seidat1/Tiny/README.md

<h1>Tiny</h1>
<h2>COMP JU+TE R</h2>
<h3><a href="https://hc-ddr.hucki.net/wiki/lib/exe/fetch.php/tiny:jutecomp1.pdf">Zeitschrift Jugend und Technik 1988</a></h3>
<h3><a href="https://hc-ddr.hucki.net/wiki/lib/exe/fetch.php/tiny/buch.pdf">Buch Tiny</a></h3>
<a target=""

<p>
Schlagworte: Tiny, Comp JU+TE r, DDR, 1988, Jugend und Technik, Zeitschrift, Rechner, Computer, 4k
</p>

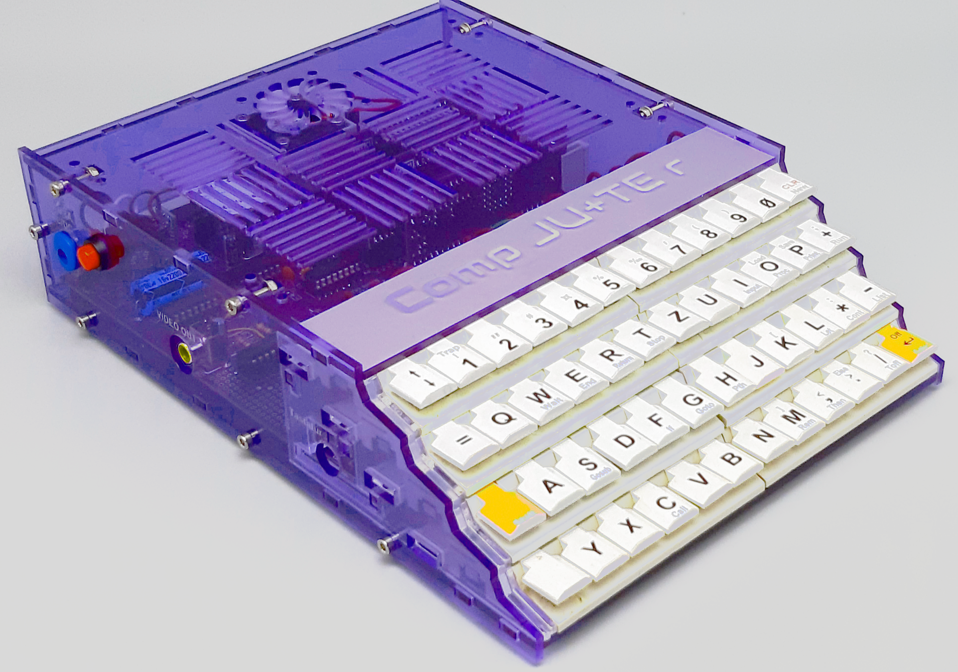
[picture p1: Bilder/vorne_links.png]
Comp Ju+TE r


<p>
Auch 35 Jahre nach Erscheinen der Artikel in des Zeitschrift Jugend und Technik werden noch "COMP JU+TE R" gebaut.
 Mir sind 2 Fälle bekannt. Beide Geräte sind lauffähig und beruhen auf der 4k-Version. Grundlage war die
 Anleitung im Buch "Tiny".
</p>

<p>
In meinem Gerät kamen Speichermodule vom Typ C zum Einsatz. Diese Steckkarte lässt sich mit 8k RAM und 8k
 EPROM bestücken. Zusätzlich wurde eine weitere Karte vom Typ C verbaut, die nur mit 8kByte RAM bestückt ist.
 Somit stehen 16k RAM zur Verfügung. Davon muss der Bildspeicher abgezogen werden.<br />
Im Gerät befindet sich eine 3. Steckkarte, auf der ein 512kByte ROM verbaut ist. Um den Adressbereich zu erweitern,
 wurde ein Zähler eingesetzt. Dieser ROM wird als ROM-Bank benutzt und beherbergt eine Datenbank mit Programmen
 für dieses Gerät.<br />
Verzichtet wurde bei meinem Gerät auf Erweiterungen, wie Tonbandanschluss und mehr.
</p>

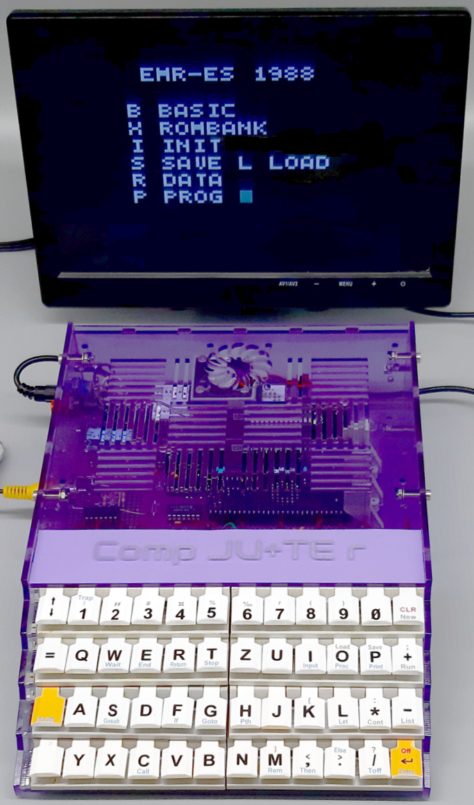
[picture p2: Bilder/Startbild.png]
Startbild


### Bilderverzeichnis:

<p>
  <table border="0">
<!-- ------------------------------ -->
    <tr>
      <td>
        <a href="./Bilder/vorne.png">Vorderansicht</a>
      </td>
      <td>
        <ul>
          <li>Vorderansicht</li>
        </ul>
      </td>
    </tr>
<!-- ------------------------------ -->
    <tr>
      <td>
        <a href="./Bilder/vorne_links.png">Ansicht vorne links</a>
      </td>
      <td>
        <ul>
          <li>Ansicht vorne links</li>
        </ul>
      </td>
    </tr>
<!-- ------------------------------ -->
    <tr>
      <td>
        <a href="./Bilder/vorne_oben.png">Ansicht vorne oben</a>
      </td>
      <td>
        <ul>
          <li>Ansicht vorne oben</li>
        </ul>
      </td>
    </tr>
<!-- ------------------------------ -->
    <tr>
      <td>
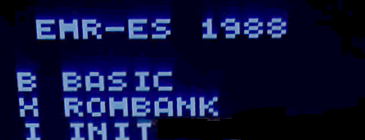
[picture p3: Bilder/verkleinert/Startbild_150px.png]
Startbild
        
      </td>
      <td>
        <ul>
          <li>Startbild</li>
        </ul>
      </td>
    </tr>
<!-- ------------------------------ -->
    <tr>
      <td>
        <a href="./Bilder/Turm_von_Hanoi.png">Turm von Hanoi</a>
      </td>
      <td>
        <ul>
          <li>Turm von Hanoi</li>
        </ul>
      </td>
    </tr>
<!-- ------------------------------ -->
    <tr>
      <td>
        <a href="./Bilder/links.png">linke Seite</a>
      </td>
      <td>
        <ul>
          <li>Netzanschluss Hohlbuchse 2,1/5,5</li>
          <li>Resettaster</li>
          <li>Compositanschluss</li>
        </ul>
      </td>
    </tr>
<!-- ------------------------------ -->
    <tr>
      <td>
        <a href="./Bilder/innen_hinten.png">innen hinten</a>
      </td>
      <td>
        <ul>
          <li>Innenansicht von hinten</li>
        </ul>
      </td>
    </tr>
<!-- ------------------------------ -->
    <tr>
      <td>
        <a href="./Bilder/innen_vorn_oben.png">innen_vorn_oben</a>
      </td>
      <td>
        <ul>
          <li>Innenansicht von vorn oben</li>
        </ul>
      </td>
    </tr>
<!-- ------------------------------ -->
    <tr>
      <td>
        <a href="./Bilder/Speicherkarten.png">Speicherkarten</a>
      </td>
      <td>
        <ul>
          <li>Speicherkarten</li>
        </ul>
      </td>
    </tr>
<!-- ------------------------------ -->
    <tr>
      <td>
        <a href="./Bilder/Platinenhalter.png">Platinenhalter</a>
      </td>
      <td>
        <ul>
          <li>Platinenhalter</li>
        </ul>
      </td>
    </tr>
<!-- ------------------------------ -->
    <tr>
      <td>
        <a href="./Bilder/Prozessor_Luefter.png">Prozessor Lüfter</a>
      </td>
      <td>
        <ul>
          <li>Prozessor L&uuml;fter</li>
        </ul>
      </td>
    </tr>
<!-- ------------------------------ -->
    <tr>
      <td>
        <a href="./Bilder/Leiterplatte_Hauptplatine_oben.png">Hauptplatine</a>
      </td>
      <td>
        <ul>
          <li>Hauptleiterplatte</li>
        </ul>
      </td>
    </tr>
<!-- ------------------------------ -->
    <tr>
      <td>
        <a href="./Bilder/Leiterplatte_Tastatur.png">Leiterplatte Tastatur</a>
      </td>
      <td>
        <ul>
          <li>Leiterplatte Tastatur</li>
        </ul>
      </td>
    </tr>
<!-- ------------------------------ -->
    <tr>
      <td>
        <a href="./Bilder/Leiterplatte_ROM_RAM.png">ROM RAM (Typ C)</a>
      </td>
      <td>
        <ul>
          <li>Leiterplatte ROM RAM</li>
        </ul>
      </td>
    </tr>
<!-- ------------------------------ -->
    <tr>
      <td>
        <a href="./Bilder/Leiterplatte_ROM_BANK.png">ROM_BANK</a>
      </td>
      <td>
        <ul>
          <li>Leiterplatte ROM BANK</li>
        </ul>
      </td>
    </tr>
<!-- ------------------------------ -->
    <tr>
      <td>
        <a href="./Bilder/UB8821_oben.png">UB8821 Bestückungsseite</a>
      </td>
      <td>
        <ul>
          <li>UB8821 Best&uuml;ckungsseite</li>
        </ul>
      </td>
    </tr>
<!-- ------------------------------ -->
    <tr>
      <td>
        <a href="./Bilder/UB8821_unten.png">UB8821 Leiterseite</a>
      </td>
      <td>
        <ul>
          <li>UB8821 Leiterseite</li>
        </ul>
      </td>
    </tr>
<!-- ------------------------------ -->
  </table>
</p>
