seidat1/Tiny/Bilder/innen_hinten.png

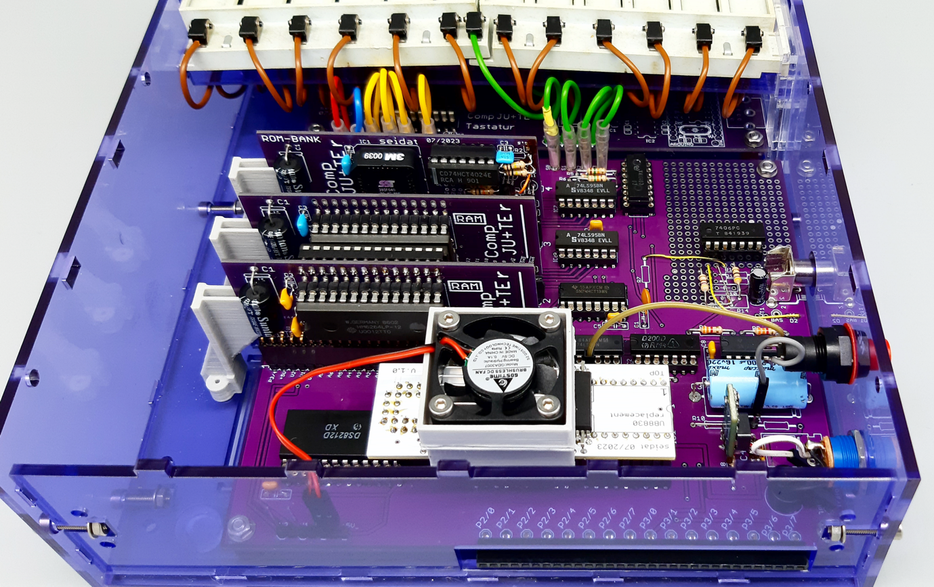
Bilder/innen_hinten.png
