seidat1/Tiny/Bilder/innen_vorn_oben.png

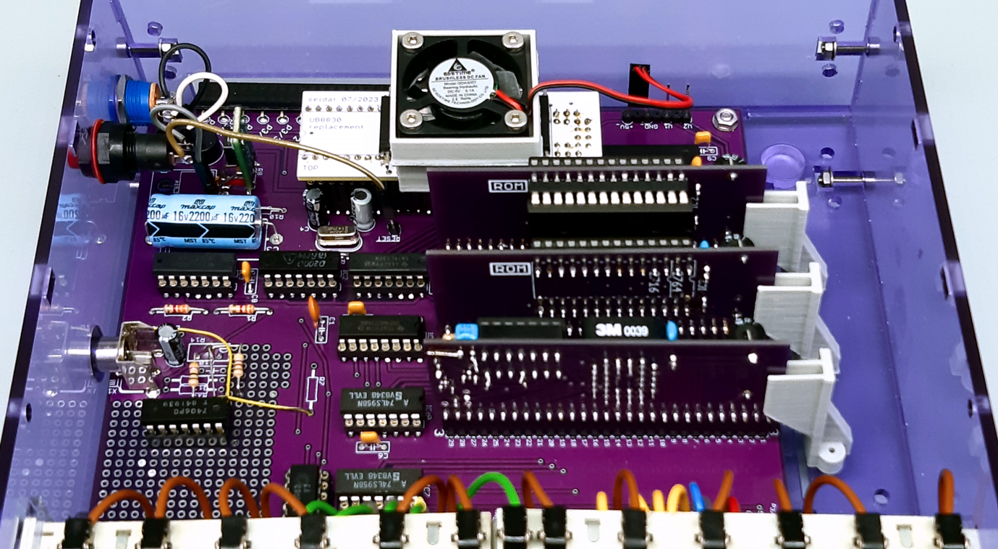
Bilder/innen_vorn_oben.png
