seidat1/Tiny/Bilder/Leiterplatte_Hauptplatine_oben.png

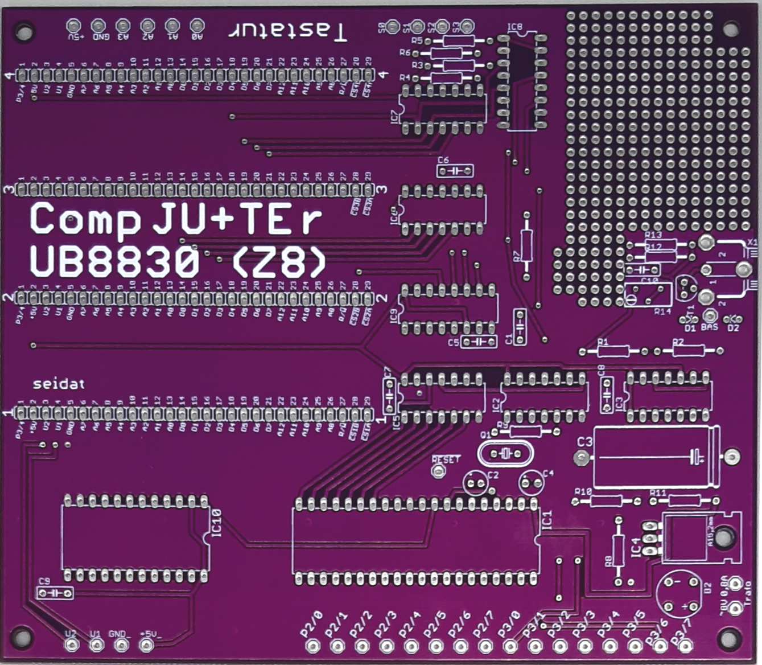
Bilder/Leiterplatte_Hauptplatine_oben.png
