seidat1/Tiny/Bilder/Leiterplatte_ROM_RAM.png

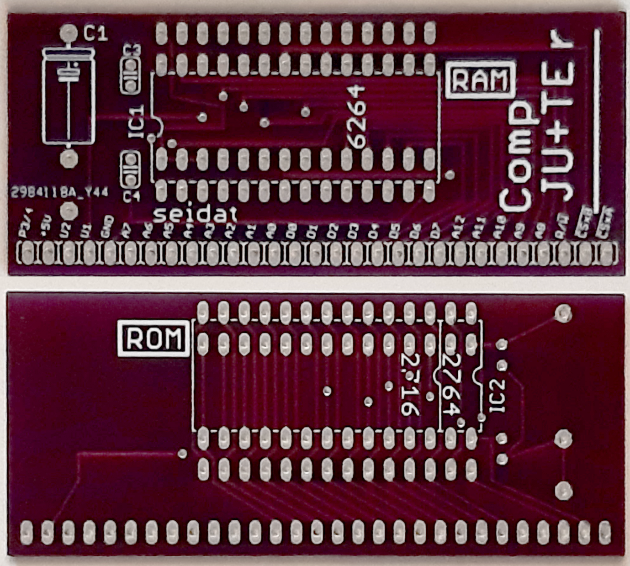
Bilder/Leiterplatte_ROM_RAM.png
