seidat1/Tiny/Bilder/Speicherkarten.png

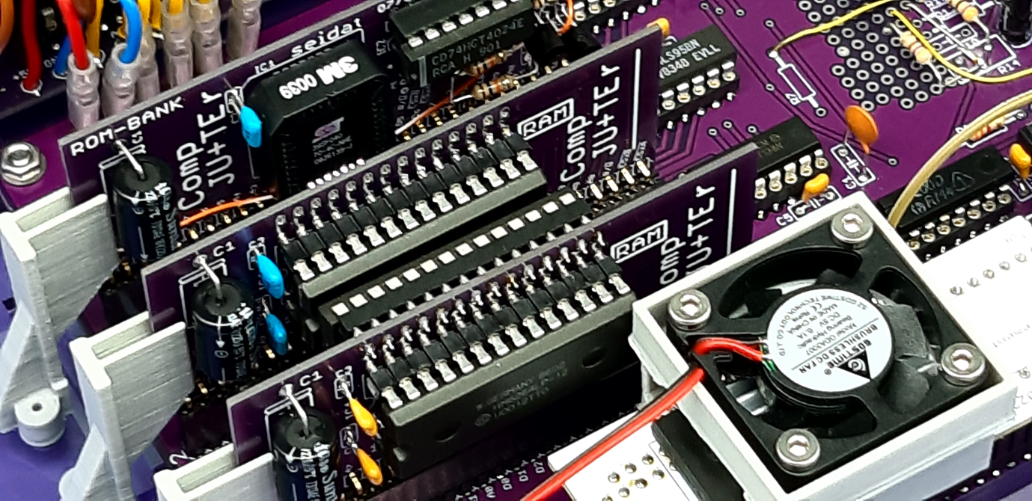
Bilder/Speicherkarten.png
