seidat1/Tiny/Bilder/Turm_von_Hanoi.png

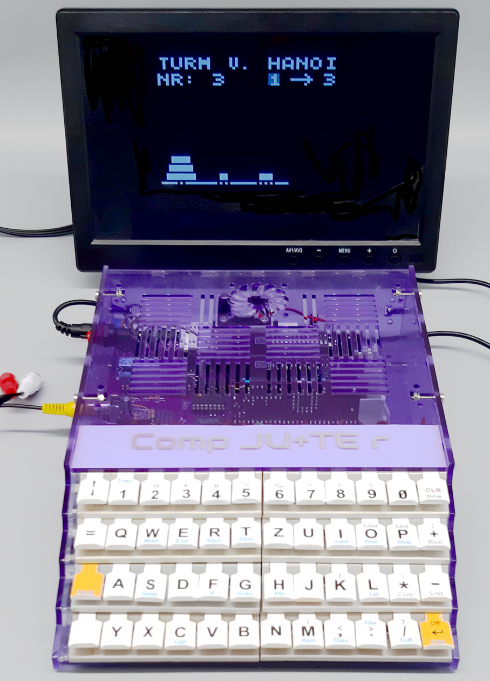
Bilder/Turm_von_Hanoi.png
