seidat1/Tiny/Bilder/UB8821_unten.png

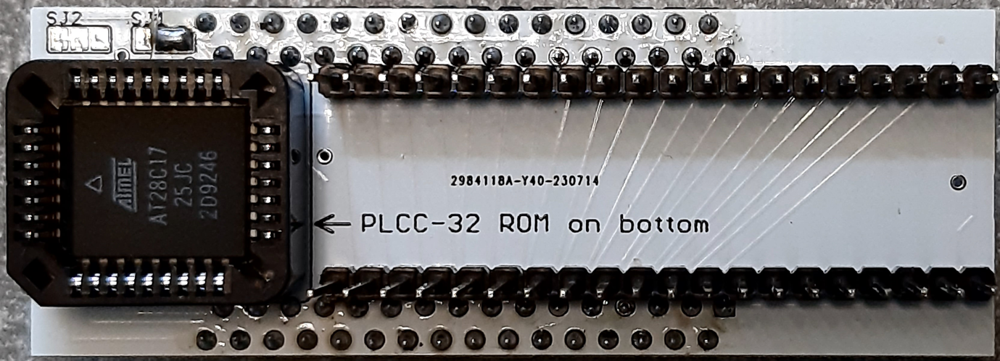
Bilder/UB8821_unten.png
