seidat1/Tiny/Bilder/vorne.png

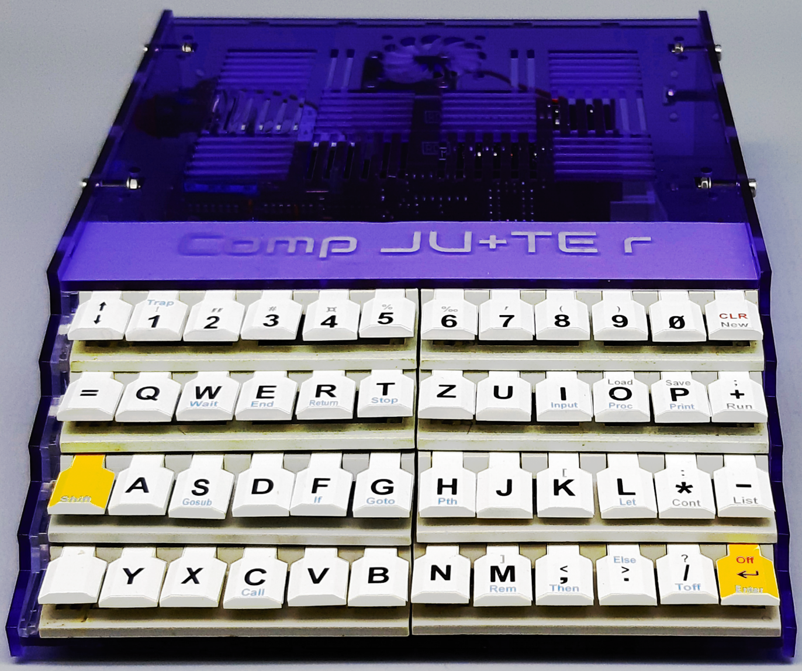
Bilder/vorne.png
