seidat1/Tiny/Bilder/vorne_oben.png

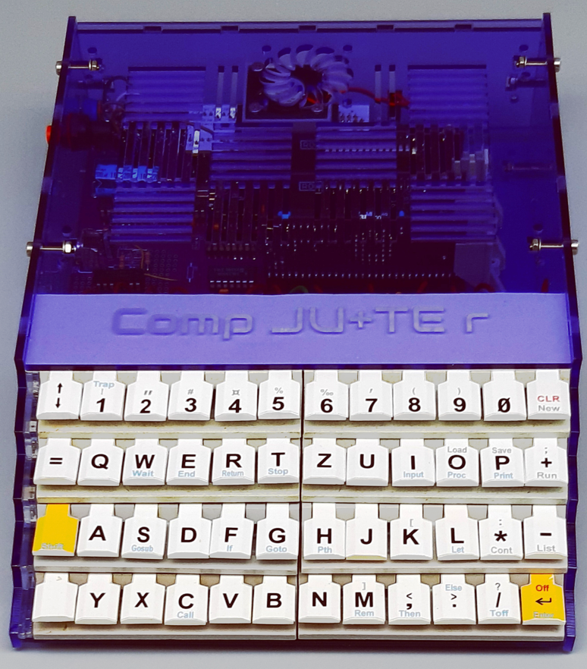
Bilder/vorne_oben.png
