seidat1/Tiny/Konstruktionsdateien/ROM BANK/Bestueckungsseite lila.png

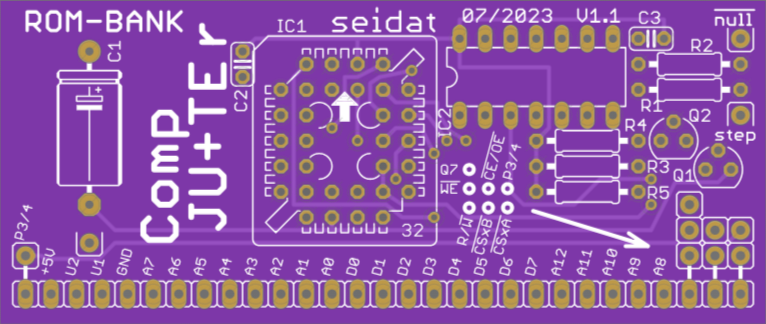
Konstruktionsdateien/ROM BANK/Bestueckungsseite lila.png
