seidat1/Tiny/Konstruktionsdateien/ROM BANK/Leiterseite lila.png

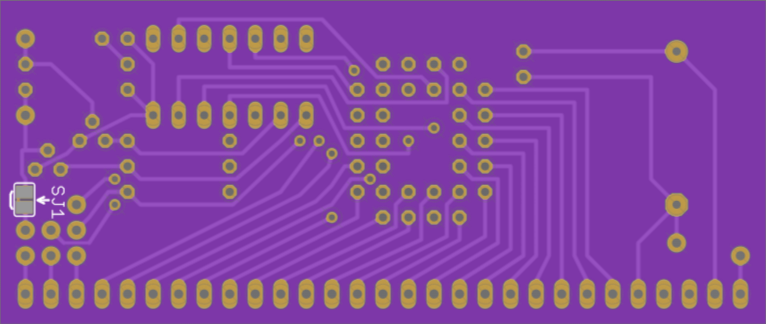
Konstruktionsdateien/ROM BANK/Leiterseite lila.png
