seidat1/Tiny/Konstruktionsdateien/ROM BANK/Leiterseite.png

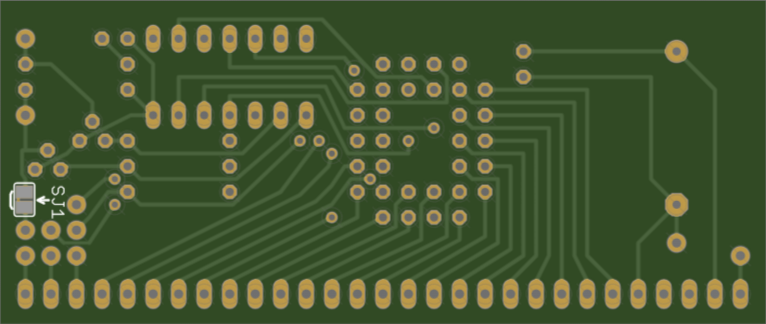
Konstruktionsdateien/ROM BANK/Leiterseite.png
