seidat1/Tiny/Konstruktionsdateien/Speicherkarte Typ C/Bestueckungsseite lila.png

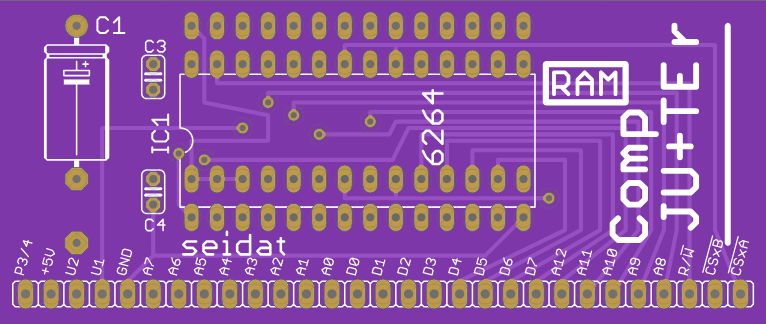
Konstruktionsdateien/Speicherkarte Typ C/Bestueckungsseite lila.png
