seidat1/Tiny/Konstruktionsdateien/Speicherkarte Typ C/Leiterseite lila.png

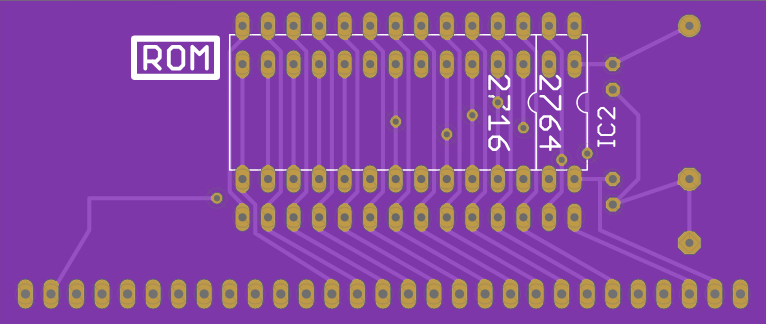
Konstruktionsdateien/Speicherkarte Typ C/Leiterseite lila.png
