seidat1/Tiny/Konstruktionsdateien/Tastatur/Bestueckungsseite lila.png

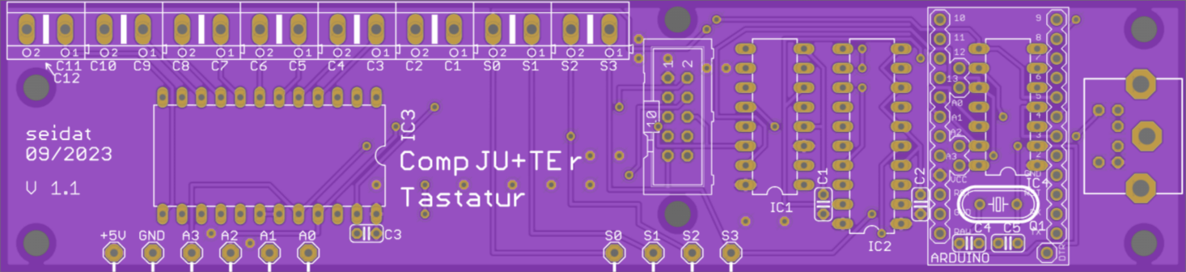
Konstruktionsdateien/Tastatur/Bestueckungsseite lila.png
