seidat1/Tiny/Konstruktionsdateien/Tastatur/Bestueckungsseite.png

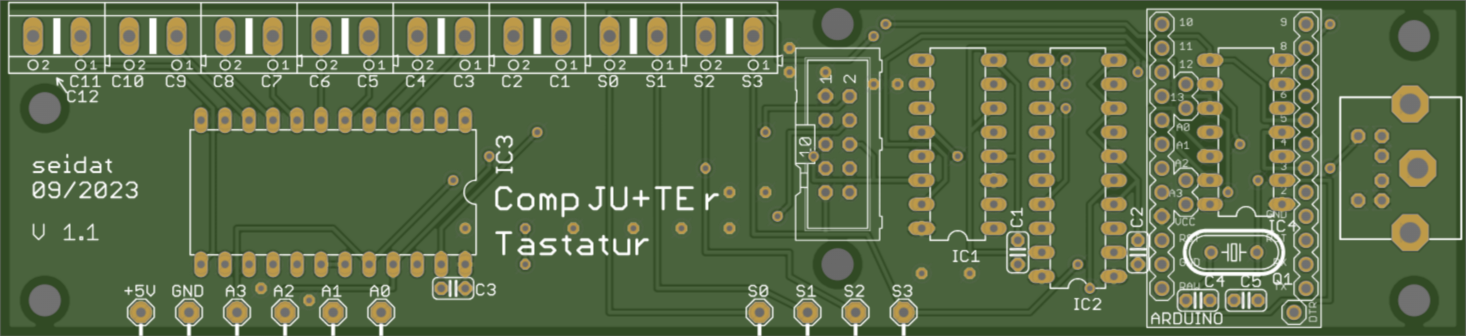
Konstruktionsdateien/Tastatur/Bestueckungsseite.png
