seidat1/Tiny/Konstruktionsdateien/Tastatur/Leiterseite lila.png

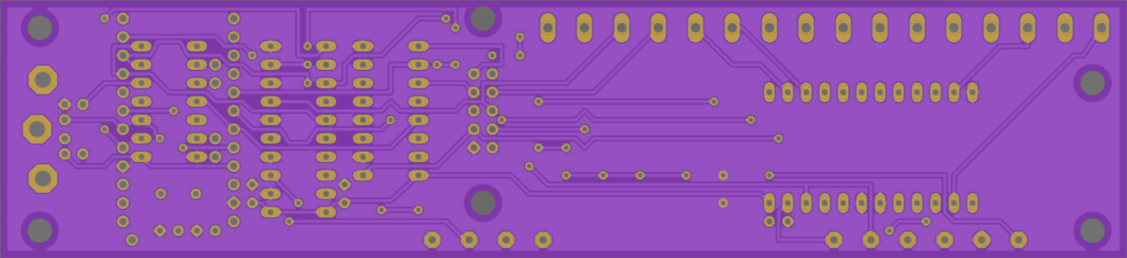
Konstruktionsdateien/Tastatur/Leiterseite lila.png
