seidat1/Tiny/Konstruktionsdateien/Tastatur/Leiterseite.png

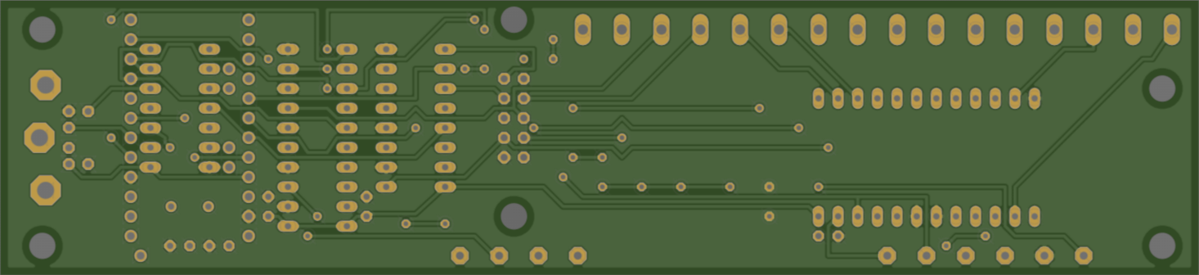
Konstruktionsdateien/Tastatur/Leiterseite.png
