seidat1/Tiny/Konstruktionsdateien/UB8830 Ersatz/Bestueckungsseite lila.png

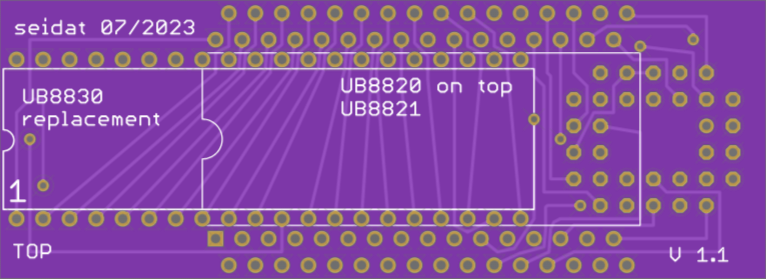
Konstruktionsdateien/UB8830 Ersatz/Bestueckungsseite lila.png
