seidat1/Tiny/Konstruktionsdateien/UB8830 Ersatz/Bestueckungsseite.png

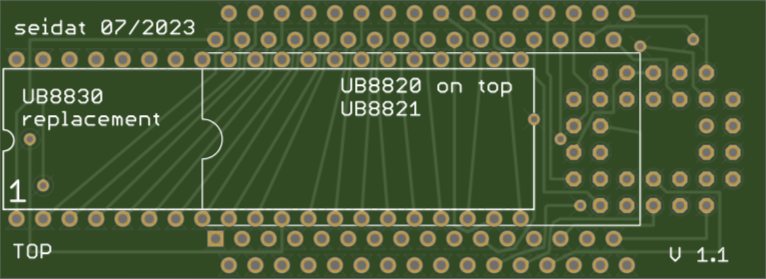
Konstruktionsdateien/UB8830 Ersatz/Bestueckungsseite.png
