seidat1/Tiny/Konstruktionsdateien/UB8830 Ersatz/Leiterseite lila.png

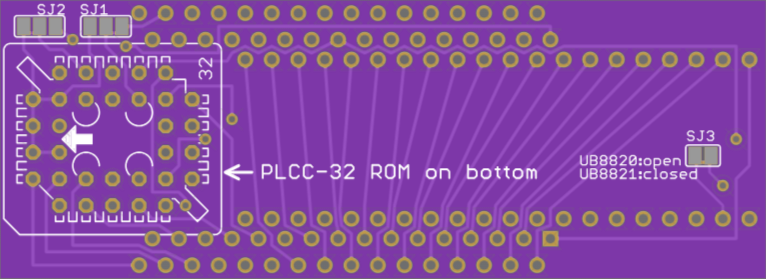
Konstruktionsdateien/UB8830 Ersatz/Leiterseite lila.png
