seidat1/Tiny/Konstruktionsdateien/UB8830 Ersatz/Leiterseite.png

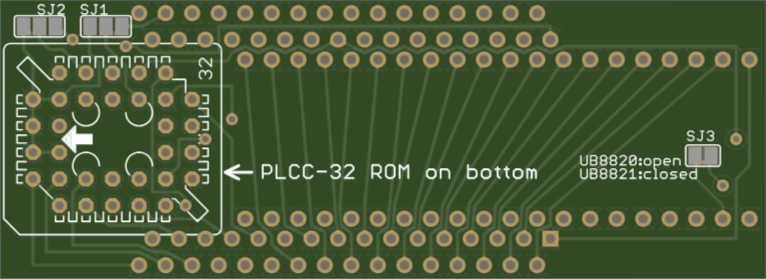
Konstruktionsdateien/UB8830 Ersatz/Leiterseite.png
