seidat1/Tiny/Konstruktionsdateien/Tastatur/Tastatur Abziehbilder.pdf

W

S

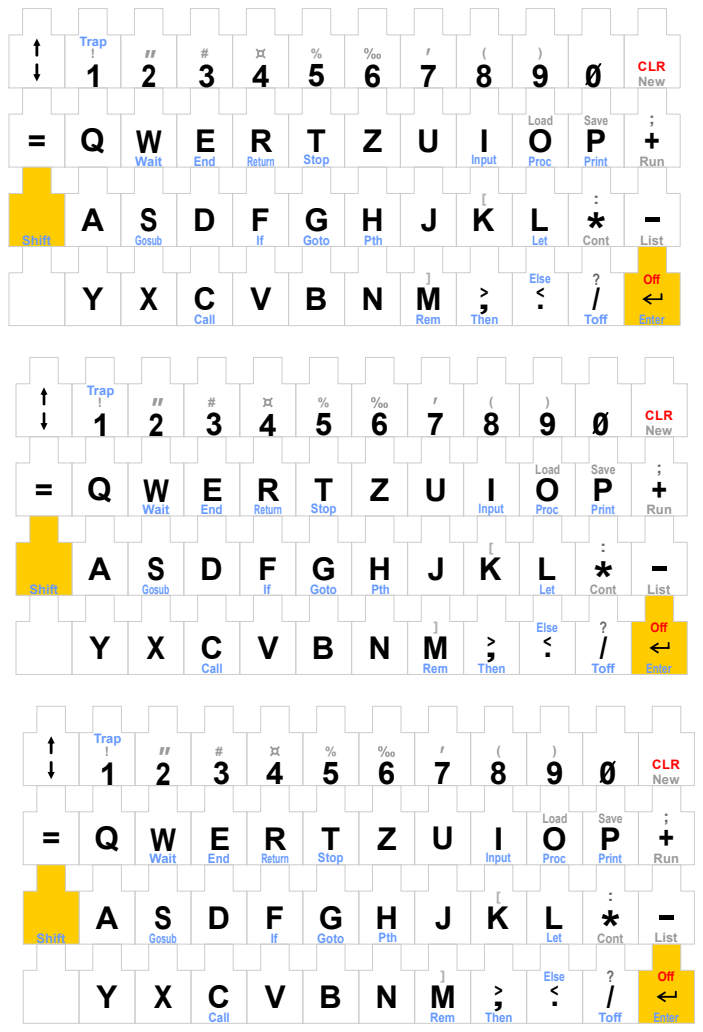
[picture p26: page 1]
Save; Load; Else; Off; Toff; Enter; List; Cont; Run; New; CLR; Input; Proc; Let; Print; Stop; End; Call; Wait; Gosub; Shift; Trap; Goto; Pth; Rem; Then; Return
