seidat1/Tiny/Konstruktionsdateien/Tastatur/Schaltplan.pdf

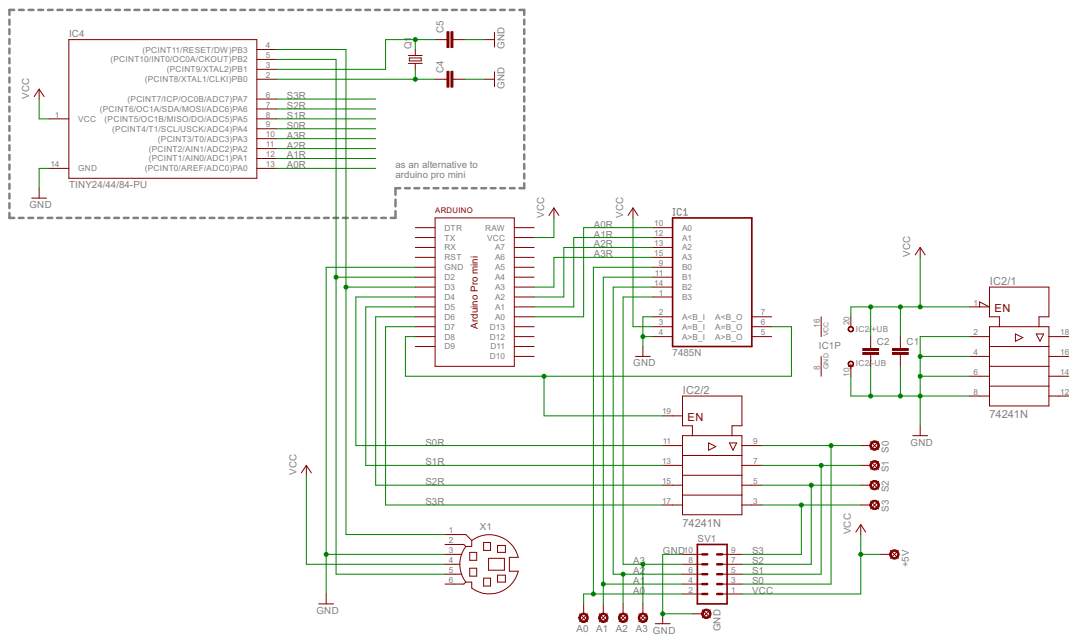
[picture p27: page 1]

6 S3R
7 S2R
8 S1R

GND 14 | 9 S0R

as an alternative to
arduino pro mini

A1R | | A1 12
A2R | | A2 13
A3R | | A3 15

B1 11
B2 14

S1R | 13
S2R | 15
S3R | 17

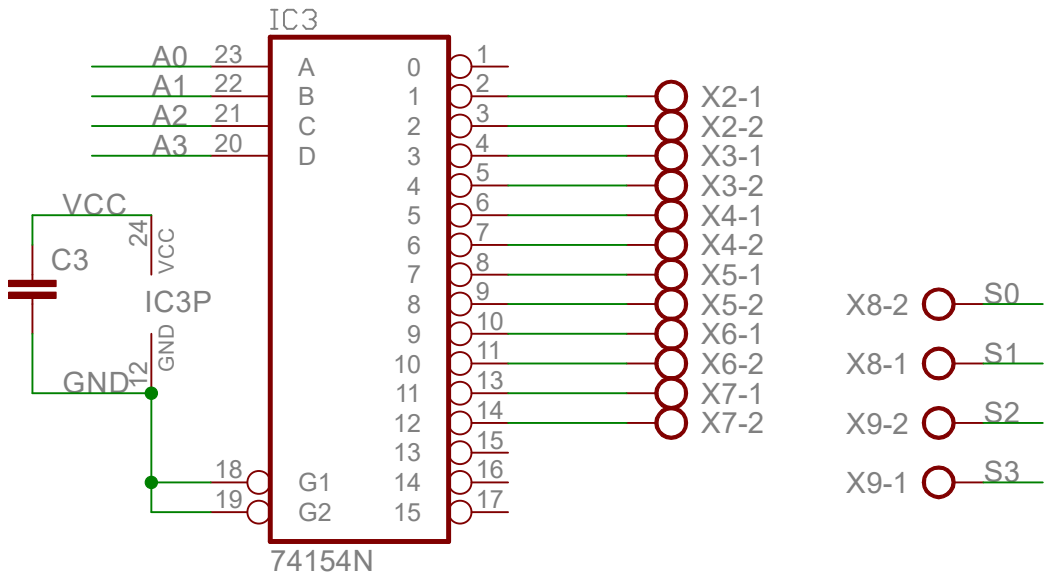
[picture p28: page 2]
IC3PGND VCC; GND; VCC
