seidat1/Tiny/Konstruktionsdateien/ROM BANK/Schaltplan.pdf

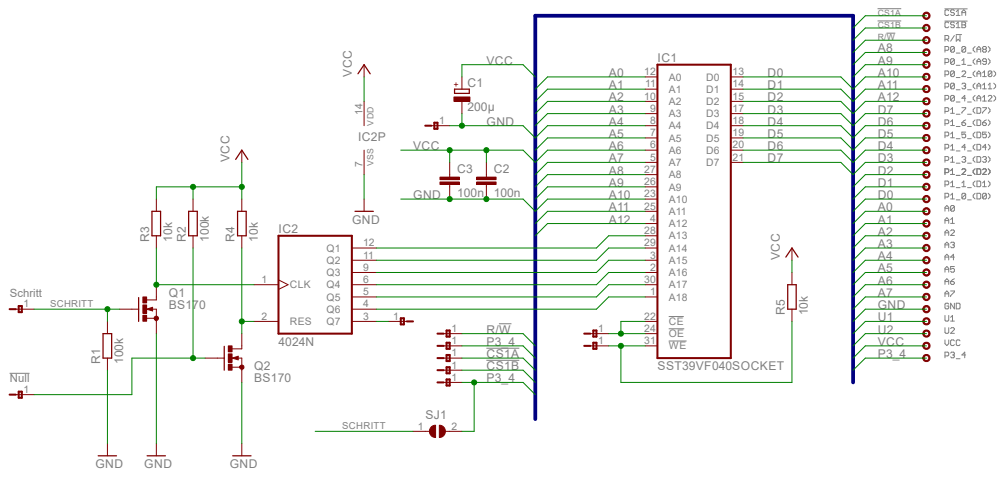
[picture p29: page 1]
