seidat1/Tiny/Konstruktionsdateien/Speicherkarte Typ C/Schaltplan.pdf

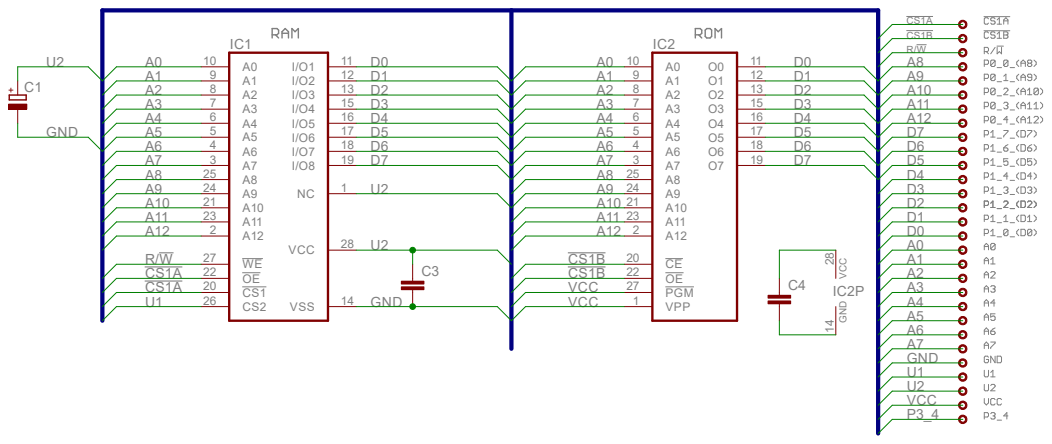
[picture p30: page 1]
