seidat1/Tiny/Konstruktionsdateien/Tastatur/Tastatur_102 EAGLE 630.brd

## EAGLE design Konstruktionsdateien/Tastatur/Tastatur_102 EAGLE 630.brd (2023-10-23)

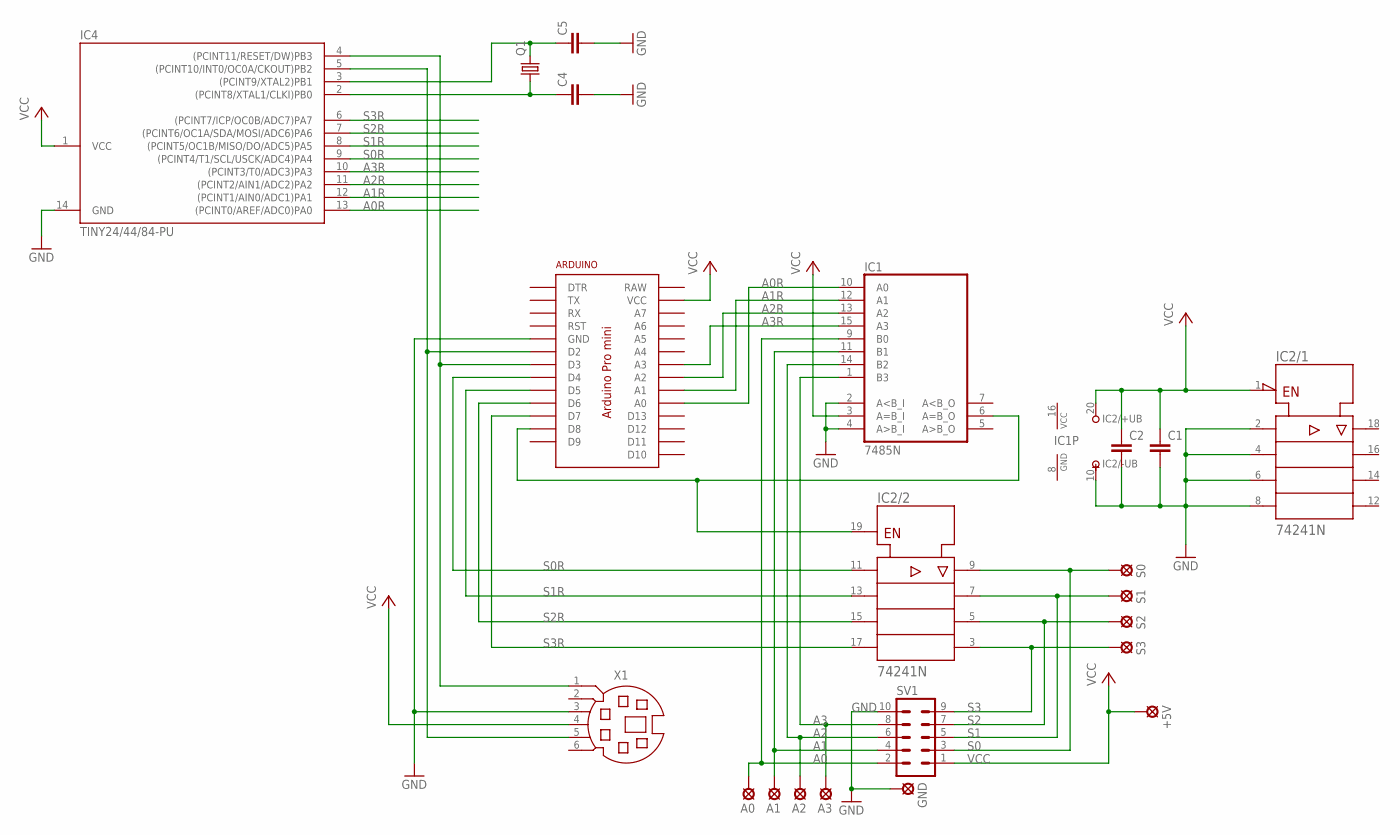
[picture p31: schematic Tastatur_102 EAGLE 630.sch, sheet 1]

Parts:
+5V: MCS10B
A0, A1, A2, A3: MCS10B
ARDUINO: ARDUINO_PRO_MINIARDUINO_PRO_MINI_8; ARDUINO_PRO_MINI_8
C1, C2, C4, C5: C-EU025-024X044; C025-024X044
GND: MCS10B
IC1: 7485N; DIL16
IC2: 74241N; DIL20
IC4: TINY24/44/84-PU; DIL14
Q1: CRYSTALHC49U-V; HC49U-V
S0, S1, S2, S3: MCS10B
SV1: ML10
X1: MD06SSMDIN06L; MDIN06SSL

Connections:
A0: A0.MP, IC1.9 (B0), SV1.2; also elsewhere on the board
A0R: ARDUINO.A0, IC1.10 (A0), IC4.13 ((PCINT0/AREF/ADC0)PA0)
A1: A1.MP, IC1.11 (B1), SV1.4; also elsewhere on the board
A1R: ARDUINO.A1, IC1.12 (A1), IC4.12 ((PCINT1/AIN0/ADC1)PA1)
A2: A2.MP, IC1.14 (B2), SV1.6; also elsewhere on the board
A2R: ARDUINO.A2, IC1.13 (A2), IC4.11 ((PCINT2/AIN1/ADC2)PA2)
A3: A3.MP, IC1.1 (B3), SV1.8; also elsewhere on the board
A3R: ARDUINO.A3, IC1.15 (A3), IC4.10 ((PCINT3/T0/ADC3)PA3)
GND: ARDUINO.GND, ARDUINO.GND@1 (GND), C1.2, C2.2, C4.2, C5.2, GND.MP, IC1.2 (A<B_I), IC1.4 (A>B_I), IC1.8 (GND), IC2.2 (A1), IC2.4 (A2), IC2.6 (A3), IC2.8 (A4), IC2.10 (-UB), IC4.14 (GND), SV1.10, X1.3; also elsewhere on the board
unnamed: ARDUINO.D2, IC4.5 ((PCINT10/INT0/OC0A/CKOUT)PB2), X1.5
unnamed: ARDUINO.D3, IC4.4 ((PCINT11/RESET/DW)PB3), X1.1
unnamed: C4.1, IC4.2 ((PCINT8/XTAL1/CLKI)PB0), Q1.1
unnamed: C5.1, IC4.3 ((PCINT9/XTAL2)PB1), Q1.2
unnamed: ARDUINO.D8, IC1.6 (A=B_O), IC2.19 (G)
S0: IC2.9 (Y1), S0.MP, SV1.3; also elsewhere on the board
S0R: ARDUINO.D4, IC2.11 (A1), IC4.9 ((PCINT4/T1/SCL/USCK/ADC4)PA4)
S1: IC2.7 (Y2), S1.MP, SV1.5; also elsewhere on the board
S1R: ARDUINO.D5, IC2.13 (A2), IC4.8 ((PCINT5/OC1B/MISO/DO/ADC5)PA5)
S2: IC2.5 (Y3), S2.MP, SV1.7; also elsewhere on the board
S2R: ARDUINO.D6, IC2.15 (A3), IC4.7 ((PCINT6/OC1A/SDA/MOSI/ADC6)PA6)
S3: IC2.3 (Y4), S3.MP, SV1.9; also elsewhere on the board
S3R: ARDUINO.D7, IC2.17 (A4), IC4.6 ((PCINT7/ICP/OC0B/ADC7)PA7)
VCC: +5V.MP, ARDUINO.VCC, C1.1, C2.1, IC1.3 (A=B_I), IC1.16 (VCC), IC2.1 (!G), IC2.20 (+UB), IC4.1 (VCC), SV1.1, X1.4; also elsewhere on the board

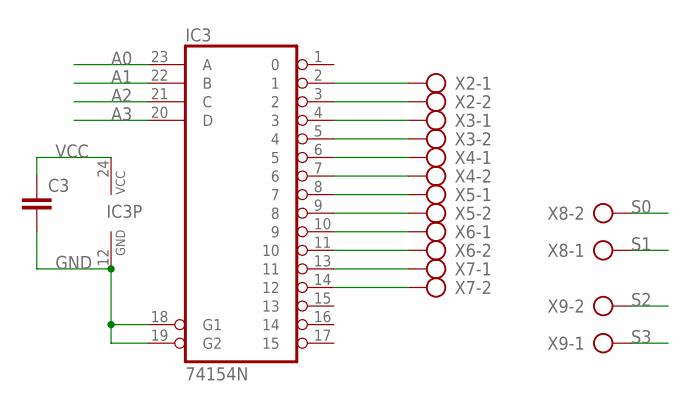
[picture p32: schematic Tastatur_102 EAGLE 630.sch, sheet 2]

Parts:
C3: C-EU025-024X044; C025-024X044
IC3: 74154N; DIL24-6
X2, X3, X4, X5, X6, X7, X8, X9: AK500/2

Connections:
A0: IC3.23 (A); also elsewhere on the board
A1: IC3.22 (B); also elsewhere on the board
A2: IC3.21 (C); also elsewhere on the board
A3: IC3.20 (D); also elsewhere on the board
GND: C3.2, IC3.12 (GND), IC3.18 (G1), IC3.19 (G2); also elsewhere on the board
unnamed: IC3.2 (1), X2.1
unnamed: IC3.3 (2), X2.2
unnamed: IC3.4 (3), X3.1
unnamed: IC3.5 (4), X3.2
unnamed: IC3.6 (5), X4.1
unnamed: IC3.7 (6), X4.2
unnamed: IC3.8 (7), X5.1
unnamed: IC3.9 (8), X5.2
unnamed: IC3.10 (9), X6.1
unnamed: IC3.11 (10), X6.2
unnamed: IC3.13 (11), X7.1
unnamed: IC3.14 (12), X7.2
S0: X8.2; also elsewhere on the board
S1: X8.1; also elsewhere on the board
S2: X9.2; also elsewhere on the board
S3: X9.1; also elsewhere on the board
VCC: C3.1, IC3.24 (VCC); also elsewhere on the board

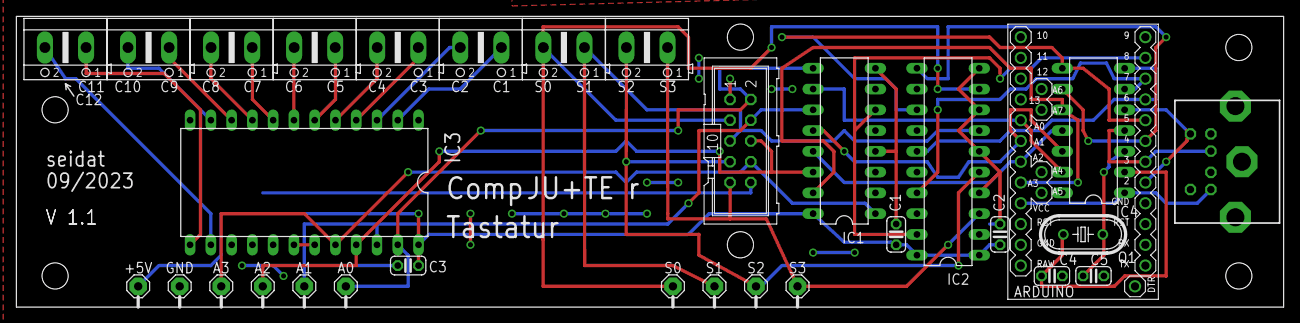
[picture p33: board Tastatur_102 EAGLE 630.brd from above]

Board: 2 copper layers, 155.0 x 35.6 mm, 31 parts (0 on the bottom side), 35 nets.
