seidat1/Tiny/Konstruktionsdateien/UB8830 Ersatz/UB8830_Ersatz_005 EAGLE 630.brd

## EAGLE design Konstruktionsdateien/UB8830 Ersatz/UB8830_Ersatz_005 EAGLE 630.brd (2023-10-22)

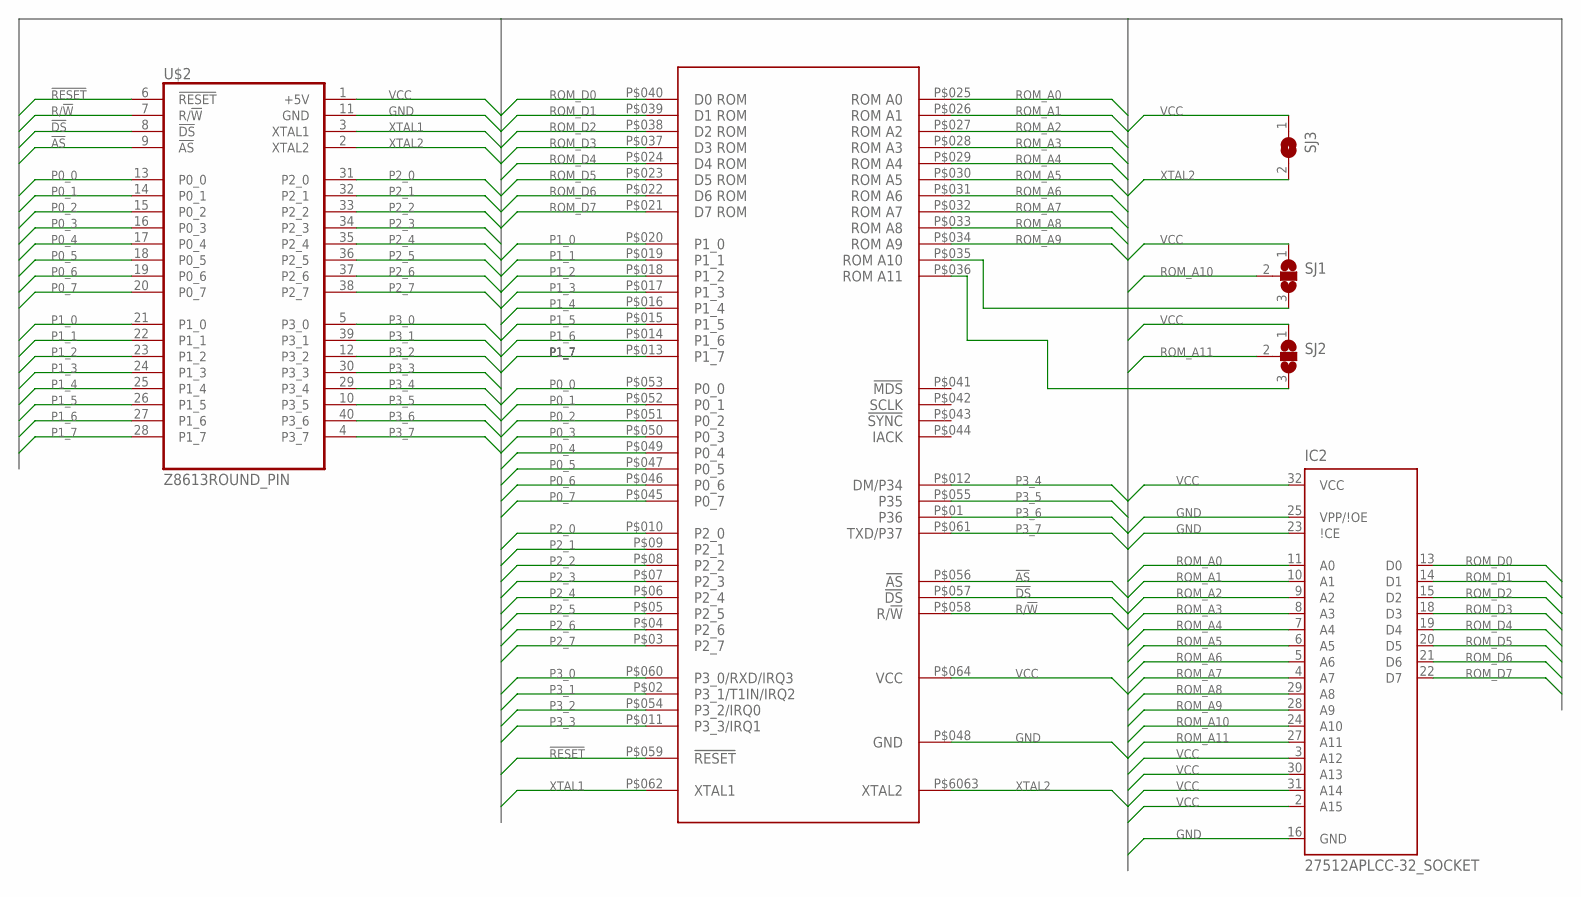
[picture p34: schematic UB8830_Ersatz_005 EAGLE 630.sch]

Parts:
IC2: 27512APLCC-32_SOCKET; PLCC-32_SOCKET
SJ1, SJ2: SJ2WSJ_2B; SJ_2B
SJ3: SJ
U$1: UB8821; QUIT64
U$2: Z8613ROUND_PIN; DIL40_ROUND

Connections:
!AS: U$1.P$056, U$2.9 (!AS)
!DS: U$1.P$057, U$2.8 (!DS)
!RESET: U$1.P$059, U$2.6 (!RESET)
GND: IC2.16 (GND), IC2.23 (\!CE), IC2.25 (VPP/\!OE), U$1.P$048, U$2.11 (GND)
unnamed: SJ1.3, U$1.P$035
unnamed: SJ2.3, U$1.P$036
P0_0: U$1.P$053, U$2.13 (P0_0)
P0_1: U$1.P$052, U$2.14 (P0_1)
P0_2: U$1.P$051, U$2.15 (P0_2)
P0_3: U$1.P$050, U$2.16 (P0_3)
P0_4: U$1.P$049, U$2.17 (P0_4)
P0_5: U$1.P$047, U$2.18 (P0_5)
P0_6: U$1.P$046, U$2.19 (P0_6)
P0_7: U$1.P$045, U$2.20 (P0_7)
P1_0: U$1.P$020, U$2.21 (P1_0)
P1_1: U$1.P$019, U$2.22 (P1_1)
P1_2: U$1.P$018, U$2.23 (P1_2)
P1_3: U$1.P$017, U$2.24 (P1_3)
P1_4: U$1.P$016, U$2.25 (P1_4)
P1_5: U$1.P$015, U$2.26 (P1_5)
P1_6: U$1.P$014, U$2.27 (P1_6)
P1_7: U$1.P$013, U$2.28 (P1_7)
P2_0: U$1.P$010, U$2.31 (P2_0)
P2_1: U$1.P$09, U$2.32 (P2_1)
P2_2: U$1.P$08, U$2.33 (P2_2)
P2_3: U$1.P$07, U$2.34 (P2_3)
P2_4: U$1.P$06, U$2.35 (P2_4)
P2_5: U$1.P$05, U$2.36 (P2_5)
P2_6: U$1.P$04, U$2.37 (P2_6)
P2_7: U$1.P$03, U$2.38 (P2_7)
P3_0: U$1.P$060, U$2.5 (P3_0)
P3_1: U$1.P$02, U$2.39 (P3_1)
P3_2: U$1.P$054, U$2.12 (P3_2)
P3_3: U$1.P$011, U$2.30 (P3_3)
P3_4: U$1.P$012, U$2.29 (P3_4)
P3_5: U$1.P$055, U$2.10 (P3_5)
P3_6: U$1.P$01, U$2.40 (P3_6)
P3_7: U$1.P$061, U$2.4 (P3_7)
R/!W: U$1.P$058, U$2.7 (R/!W)
ROM_A0: IC2.11 (A0), U$1.P$025
ROM_A1: IC2.10 (A1), U$1.P$026
ROM_A2: IC2.9 (A2), U$1.P$027
ROM_A3: IC2.8 (A3), U$1.P$028
ROM_A4: IC2.7 (A4), U$1.P$029
ROM_A5: IC2.6 (A5), U$1.P$030
ROM_A6: IC2.5 (A6), U$1.P$031
ROM_A7: IC2.4 (A7), U$1.P$032
ROM_A8: IC2.29 (A8), U$1.P$033
ROM_A9: IC2.28 (A9), U$1.P$034
ROM_A10: IC2.24 (A10), SJ1.2
ROM_A11: IC2.27 (A11), SJ2.2
ROM_D0: IC2.13 (D0), U$1.P$040
ROM_D1: IC2.14 (D1), U$1.P$039
ROM_D2: IC2.15 (D2), U$1.P$038
ROM_D3: IC2.18 (D3), U$1.P$037
ROM_D4: IC2.19 (D4), U$1.P$024
ROM_D5: IC2.20 (D5), U$1.P$023
ROM_D6: IC2.21 (D6), U$1.P$022
ROM_D7: IC2.22 (D7), U$1.P$021
VCC: IC2.2 (A15), IC2.3 (A12), IC2.30 (A13), IC2.31 (A14), IC2.32 (VCC), SJ1.1, SJ2.1, SJ3.1, U$1.P$064, U$2.1 (+5V)
XTAL1: U$1.P$062, U$2.3 (XTAL1)
XTAL2: SJ3.2, U$1.P$6063, U$2.2 (XTAL2)

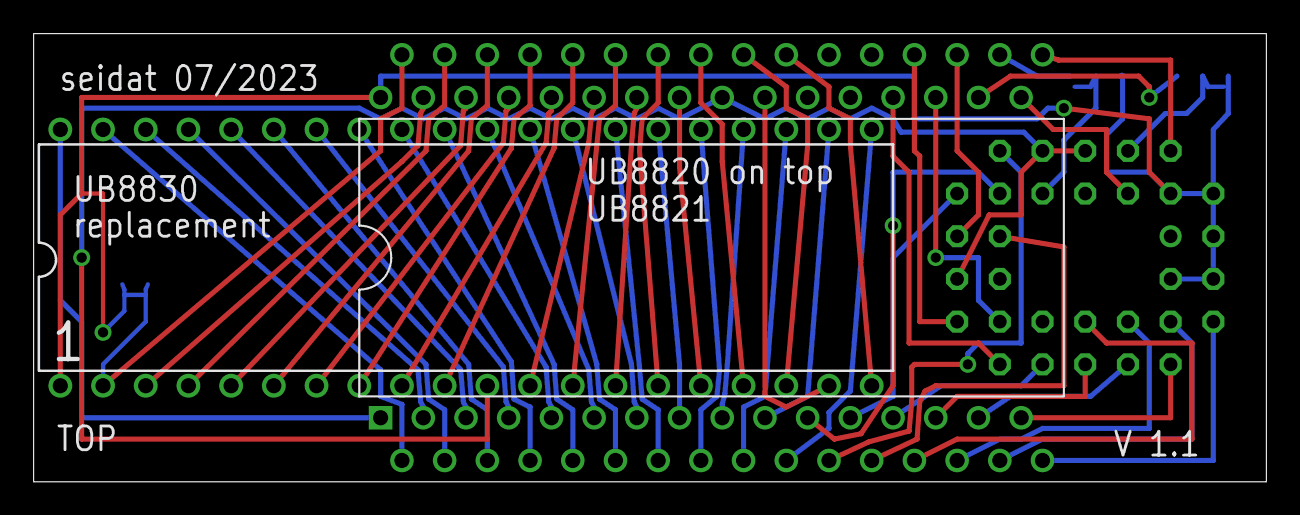
[picture p35: board UB8830_Ersatz_005 EAGLE 630.brd from above]

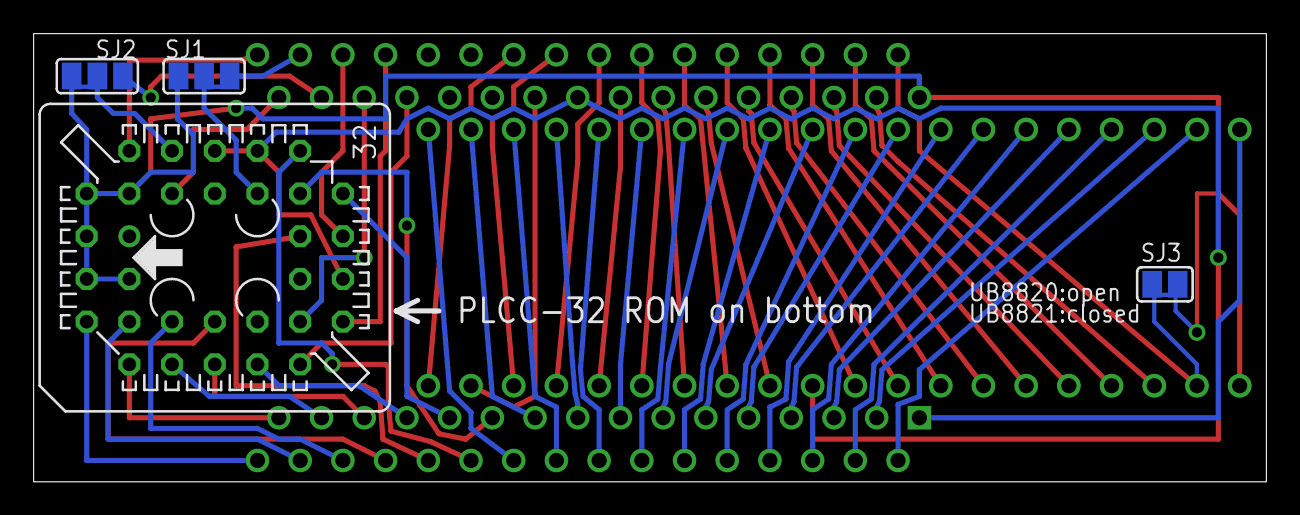
[picture p36: board UB8830_Ersatz_005 EAGLE 630.brd from below]

Board: 2 copper layers, 73.3 x 26.7 mm, 6 parts (4 on the bottom side), 62 nets.
