seidat1/Tiny/Konstruktionsdateien/Speicherkarte Typ C/Modul_C_002x EAGLE 630.brd

## EAGLE design Konstruktionsdateien/Speicherkarte Typ C/Modul_C_002x EAGLE 630.brd (2023-10-22)

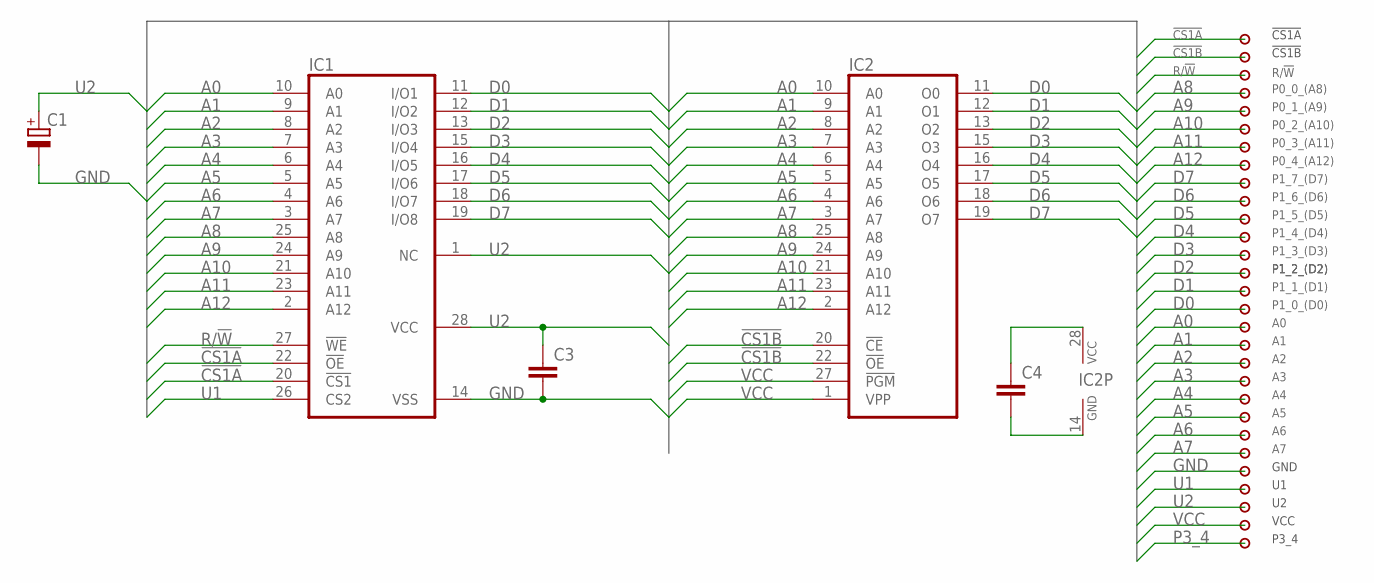
[picture p39: schematic Modul_C_002x EAGLE 630.sch]

Parts:
C1: CPOL-EUE15-6AXIAL; E15-6
C3, C4: C-EU025-024X044; C025-024X044
IC1: 6264A; DIL28-6
IC2: 2764; DIL28
U$1: BUS2929PUR; BUS29_PUR

Connections:
!CS1A: IC1.20 (!CS1), IC1.22 (!OE), U$1.1.29
!CS1B: IC2.20 (!CE), IC2.22 (!OE), U$1.1.28
A0: IC1.10 (A0), IC2.10 (A0), U$1.1.13
A1: IC1.9 (A1), IC2.9 (A1), U$1.1.12
A2: IC1.8 (A2), IC2.8 (A2), U$1.1.11
A3: IC1.7 (A3), IC2.7 (A3), U$1.1.10
A4: IC1.6 (A4), IC2.6 (A4), U$1.1.9
A5: IC1.5 (A5), IC2.5 (A5), U$1.1.8
A6: IC1.4 (A6), IC2.4 (A6), U$1.1.7
A7: IC1.3 (A7), IC2.3 (A7), U$1.1.6
A8: IC1.25 (A8), IC2.25 (A8), U$1.1.26
A9: IC1.24 (A9), IC2.24 (A9), U$1.1.25
A10: IC1.21 (A10), IC2.21 (A10), U$1.1.24
A11: IC1.23 (A11), IC2.23 (A11), U$1.1.23
A12: IC1.2 (A12), IC2.2 (A12), U$1.1.22
D0: IC1.11 (I/O1), IC2.11 (O0), U$1.1.14
D1: IC1.12 (I/O2), IC2.12 (O1), U$1.1.15
D2: IC1.13 (I/O3), IC2.13 (O2), U$1.1.16
D3: IC1.15 (I/O4), IC2.15 (O3), U$1.1.17
D4: IC1.16 (I/O5), IC2.16 (O4), U$1.1.18
D5: IC1.17 (I/O6), IC2.17 (O5), U$1.1.19
D6: IC1.18 (I/O7), IC2.18 (O6), U$1.1.20
D7: IC1.19 (I/O8), IC2.19 (O7), U$1.1.21
GND: C1.-, C3.2, C4.2, IC1.14 (VSS), IC2.14 (GND), U$1.1.5
P3_4: U$1.1.1
R/!W: IC1.27 (!WE), U$1.1.27
U1: IC1.26 (CS2), U$1.1.4
U2: C1.+, C3.1, IC1.1 (NC), IC1.28 (VCC), U$1.1.3
VCC: C4.1, IC2.1 (VPP), IC2.27 (!PGM), IC2.28 (VCC), U$1.1.2

Notes on the sheet:
!CS1B
!CS1A
GND
VCC
P3_4

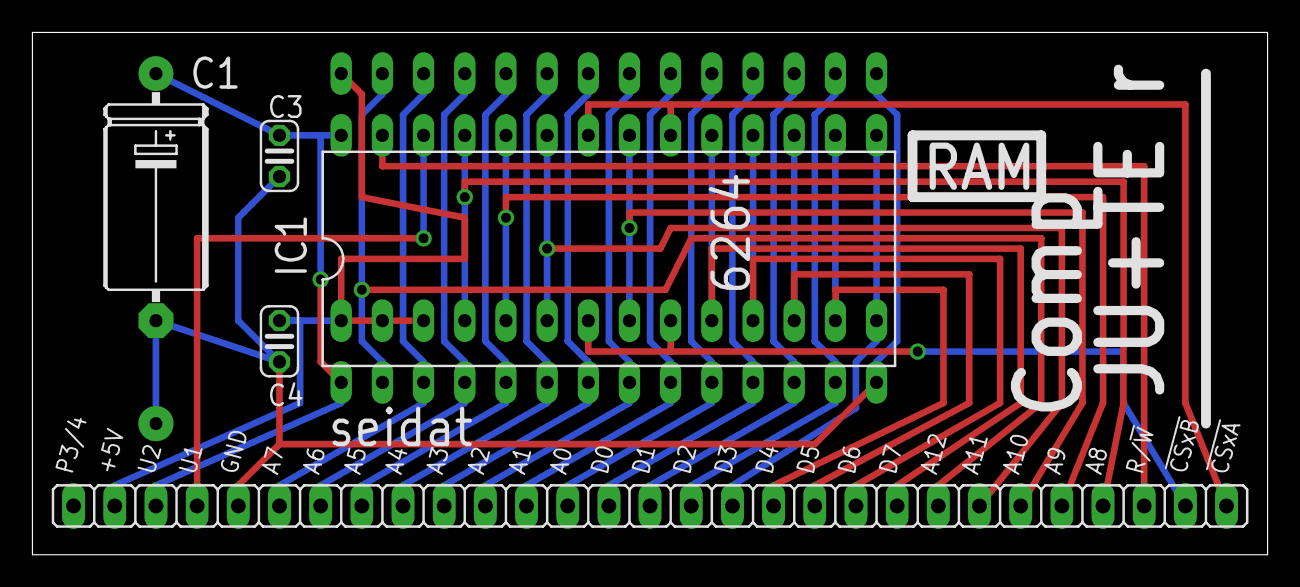
[picture p40: board Modul_C_002x EAGLE 630.brd from above]

Board: 2 copper layers, 76.2 x 32.2 mm, 6 parts (1 on the bottom side), 28 nets.
